philipdinn/Individual-Project/Hình/370251362_1060291348654980_7661585356005845768_n.jpg

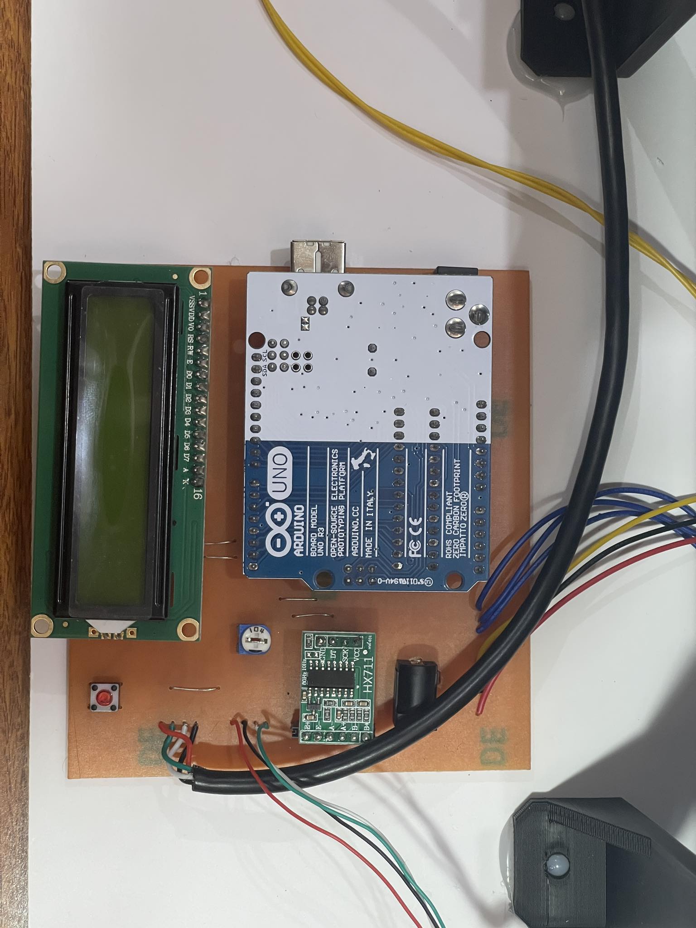
Hình/370251362_1060291348654980_7661585356005845768_n.jpg
