philipdinn/Individual-Project/Hình/12VDC cũ.jpg

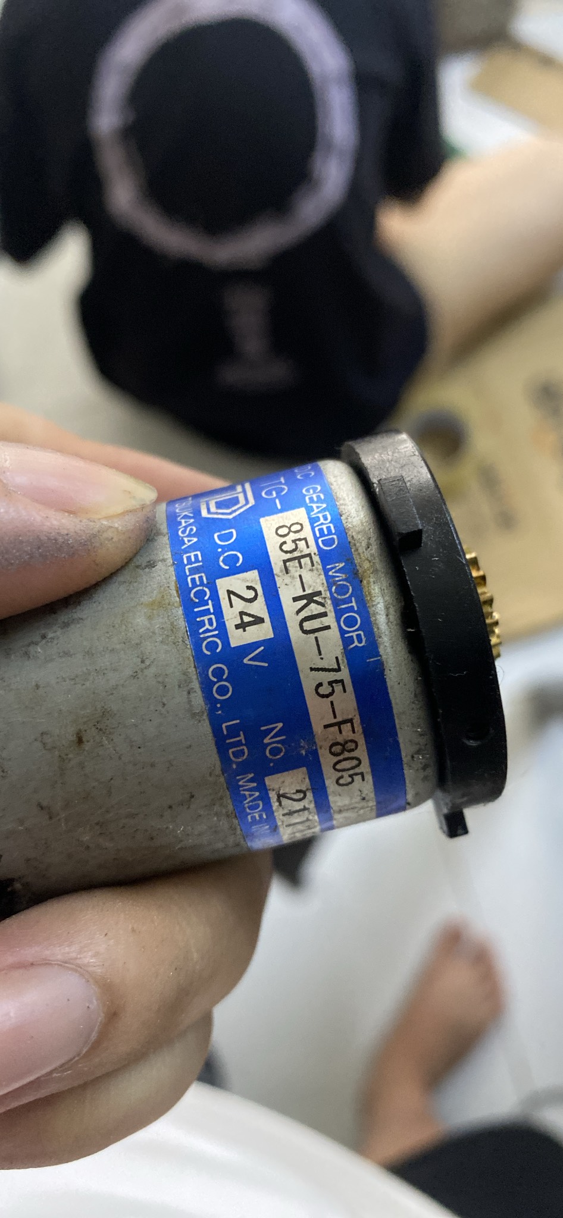
Hình/12VDC cũ.jpg
