philipdinn/Individual-Project/README.md

# Individual-Project
Precision weighing and speed monitoring on conveyor systems are essential for quality and efficiency in modern manufacturing. Traditional static scales can't measure the weight of moving products. Dynamic weighing systems solve this by accurately measuring product weight while they move down the conveyor, without halting the belt.
