philipdinn/Individual-Project/Hình Khối.pptx

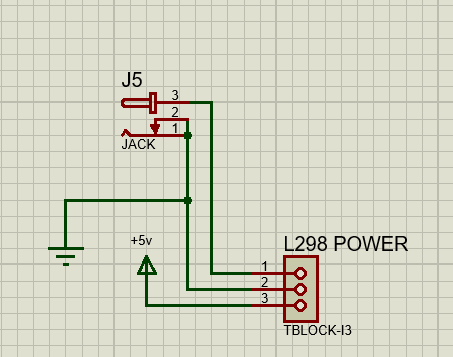
[picture p8: figure]

POWER BLOCK

## Slide 2

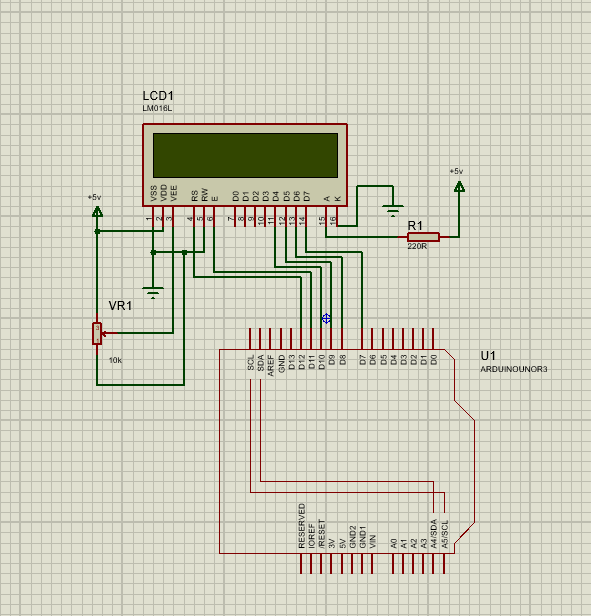
[picture p9: figure]

DISPLAY BLOCK

## Slide 3

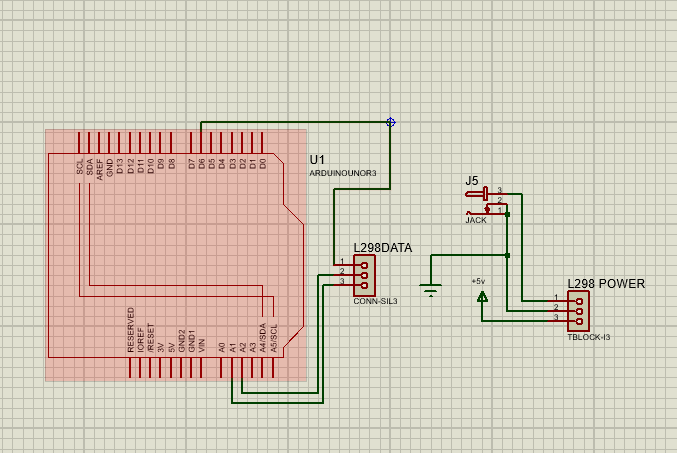
[picture p10: figure]

L298N BLOCK

## Slide 4

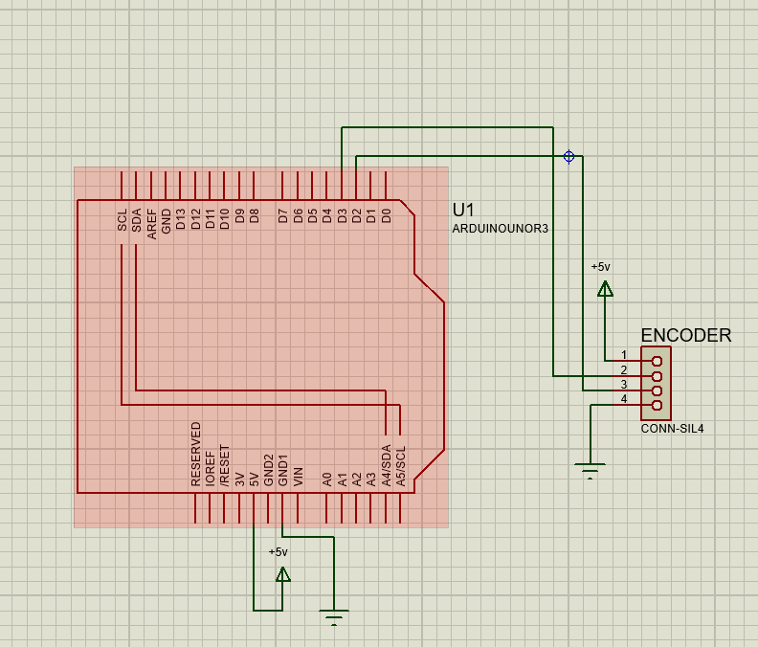
[picture p11: figure]

ENCODER BLOCK

## Slide 5

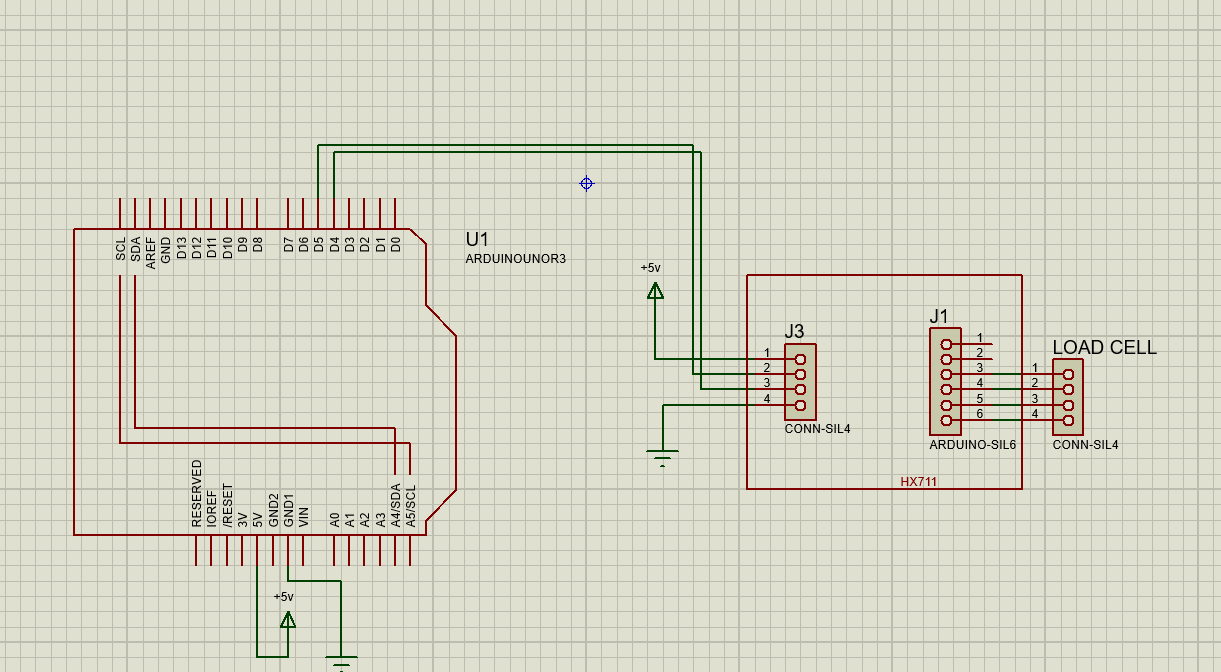
[picture p12: figure]

LOADCELL BLOCK

## Slide 6

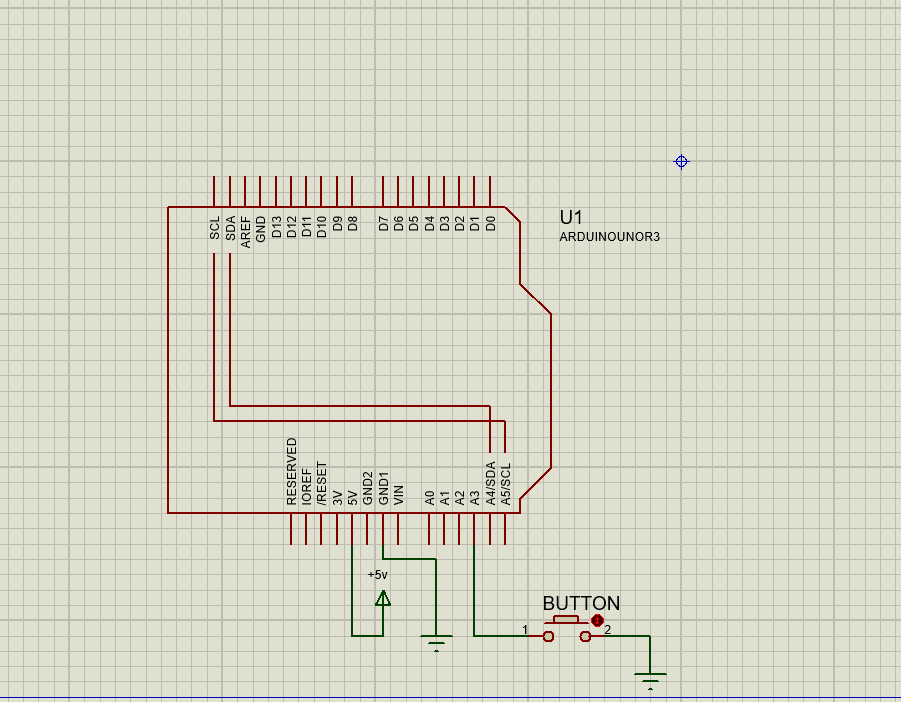
[picture p13: figure]

MAIN PROCESSING BLOCK

## Slide 7

## Slide 8

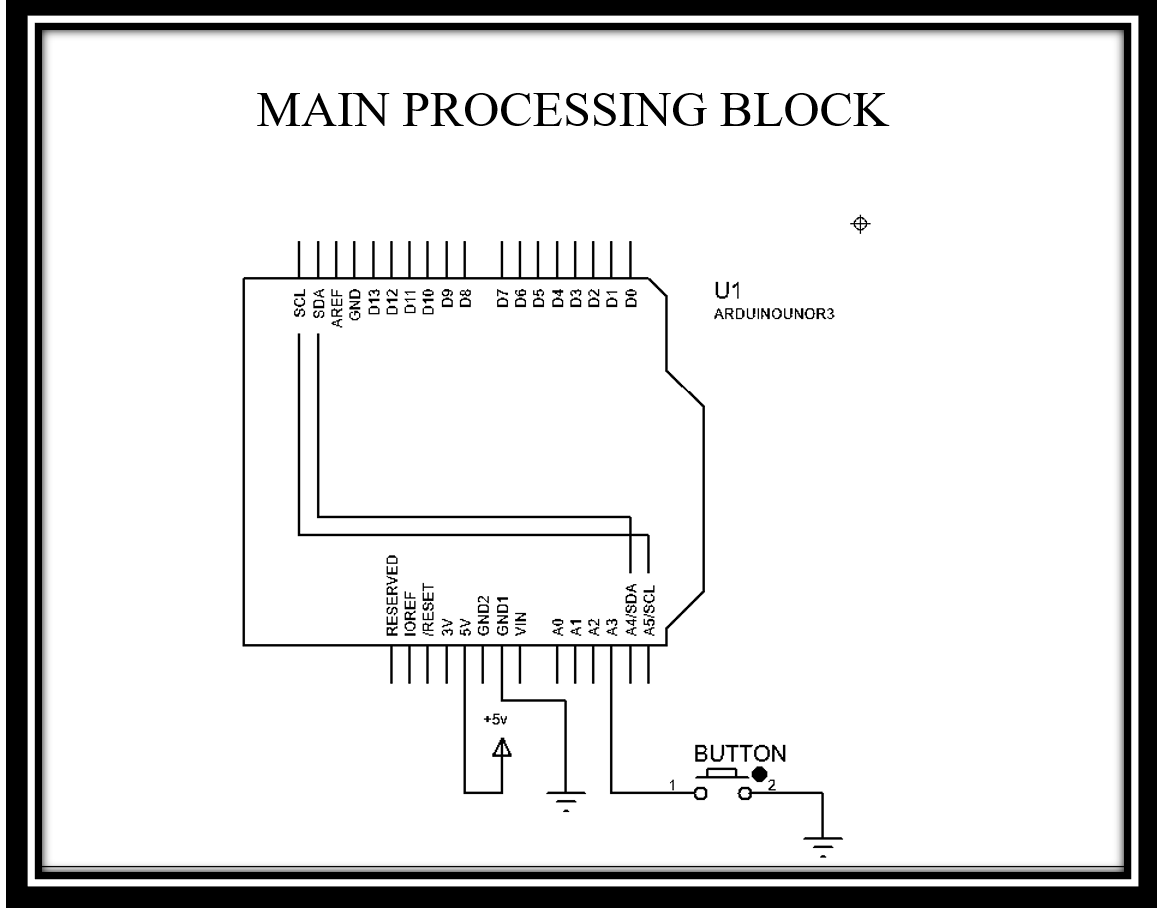
[picture p14: figure]
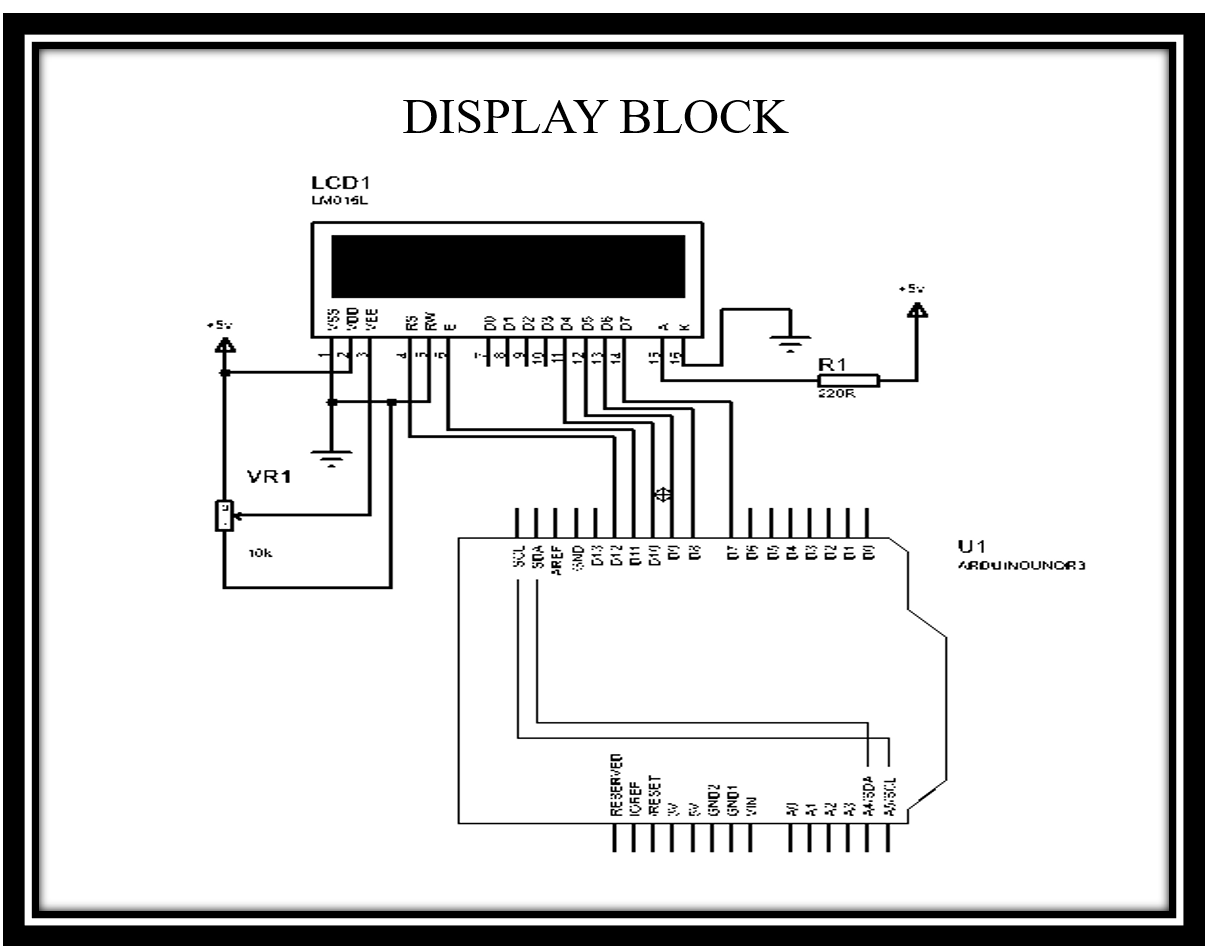
[picture p15: figure]
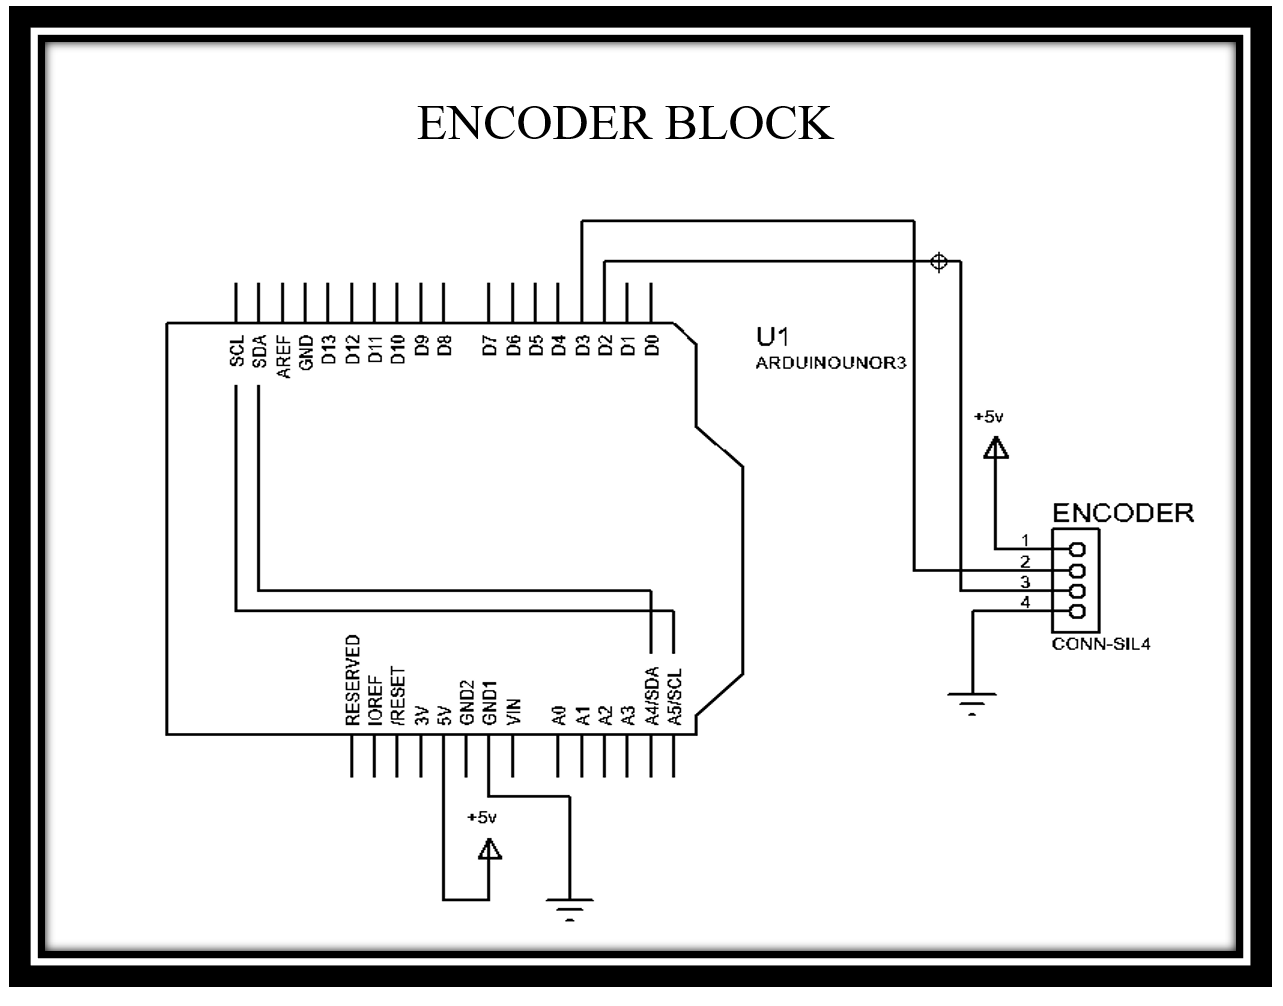
[picture p16: figure]
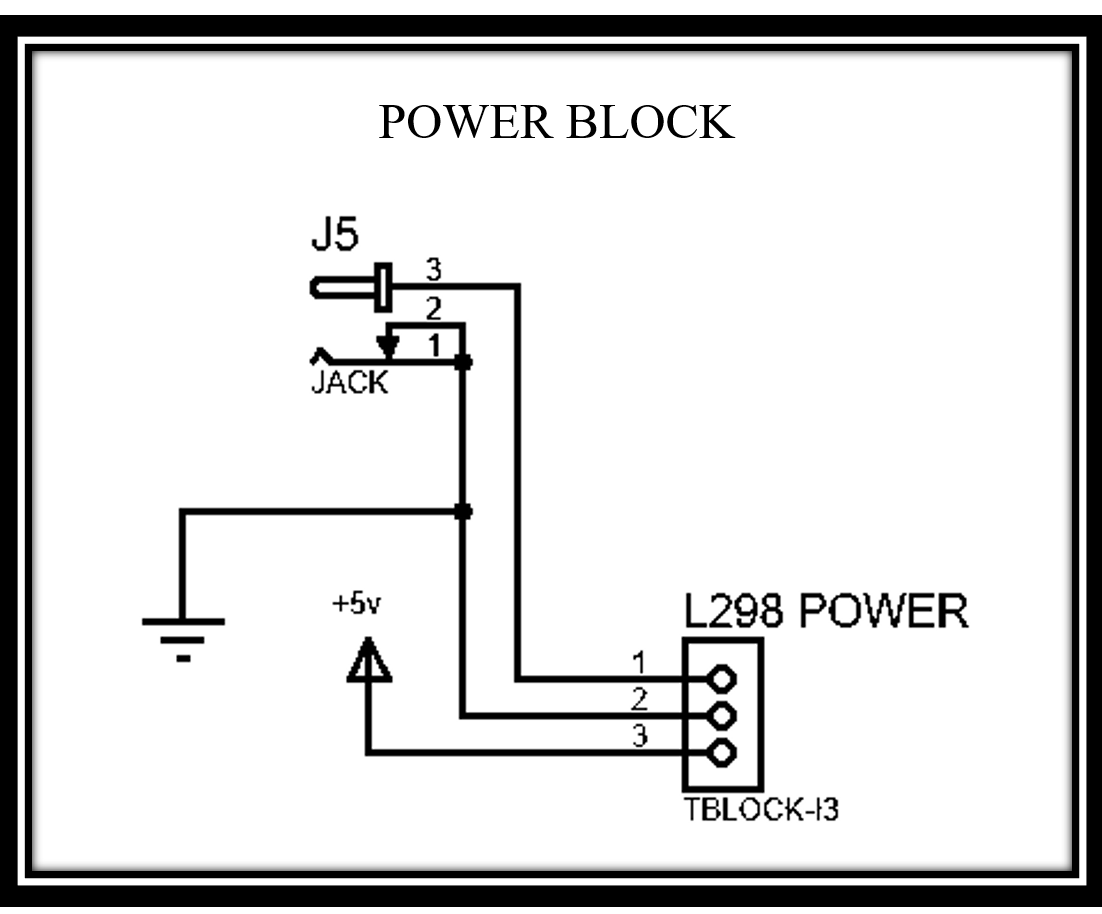
[picture p17: figure]
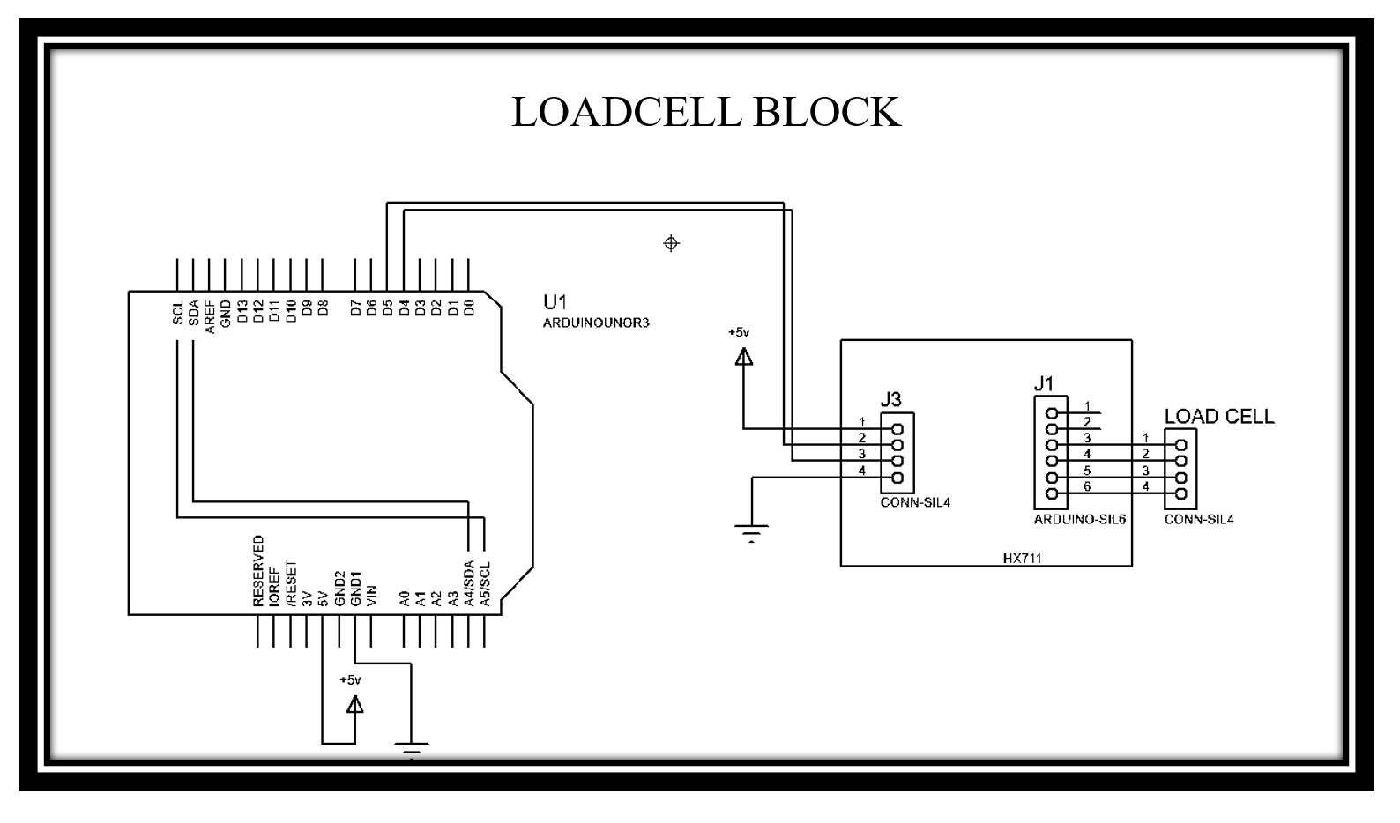
[picture p18: figure]
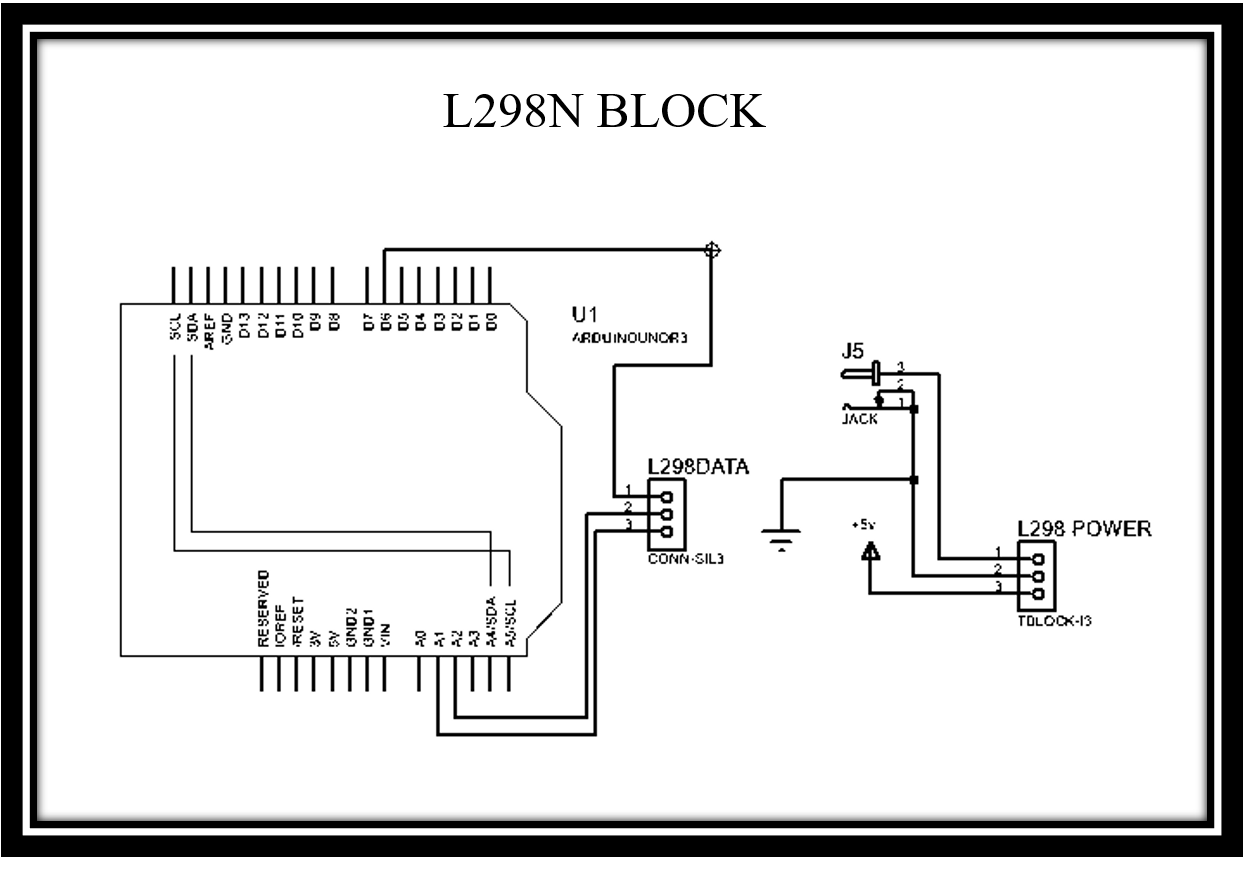
[picture p19: figure]

## Slide 9

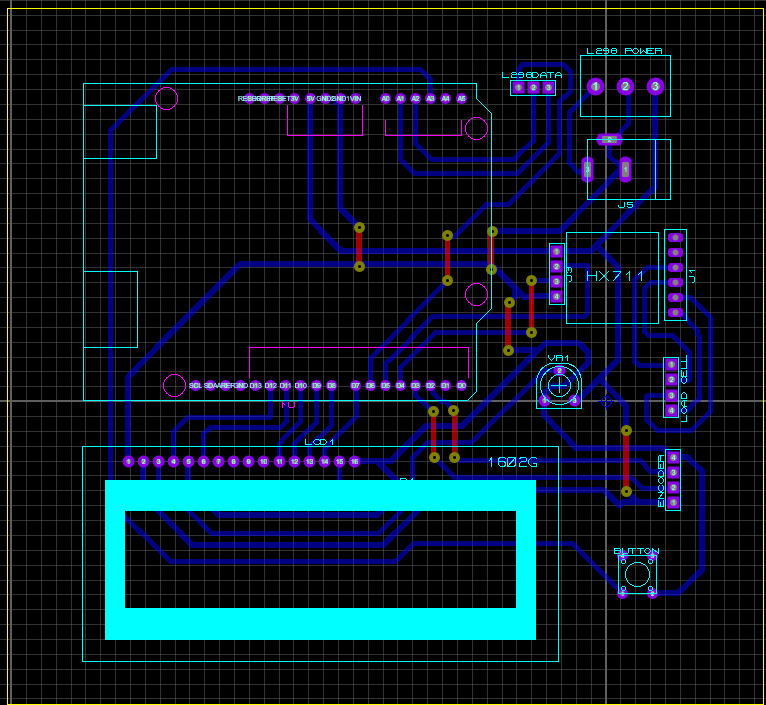
[picture p20: figure]
