philipdinn/Individual-Project/Hình/50.png

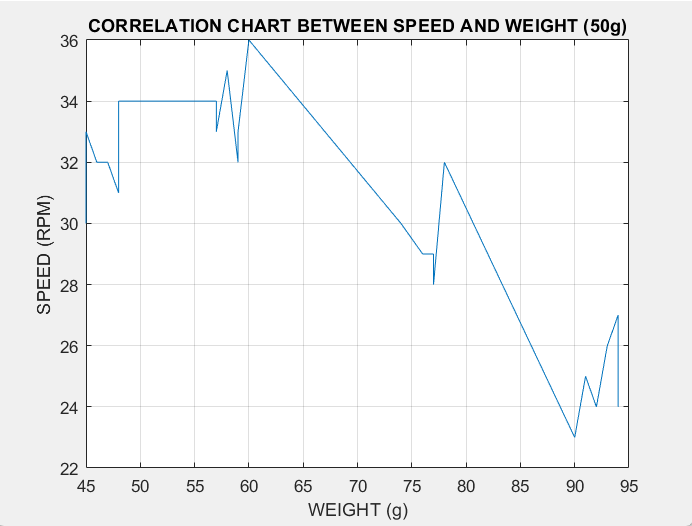
Hình/50.png
