philipdinn/Individual-Project/Hình/70.png

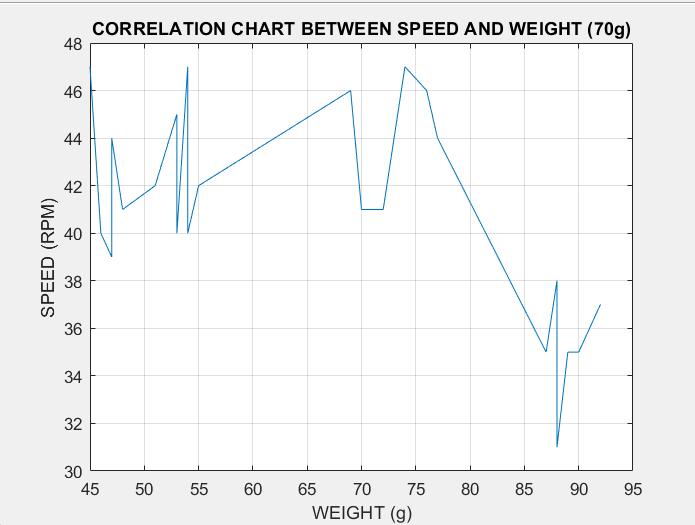
Hình/70.png
