philipdinn/Individual-Project/Hình/90.png

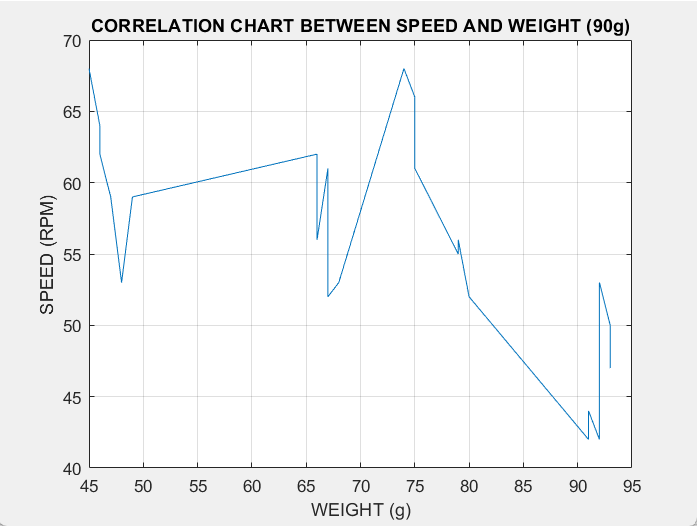
Hình/90.png
