philipdinn/Individual-Project/Hình/100.png

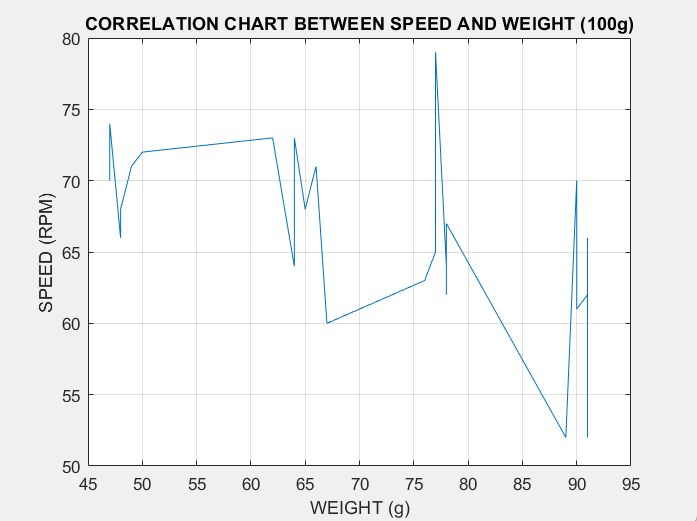
Hình/100.png
