philipdinn/Individual-Project/Hình/370220347_3696432520637470_9133561006674503579_n.jpg

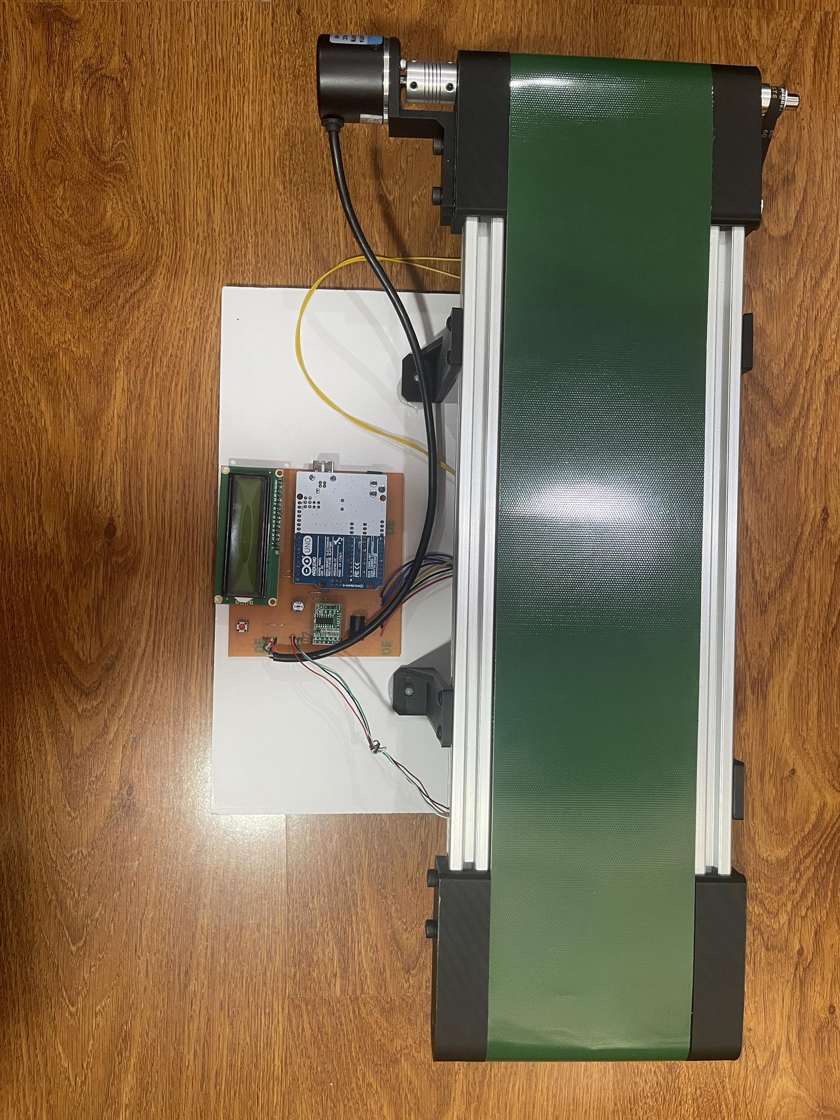
Hình/370220347_3696432520637470_9133561006674503579_n.jpg
