philipdinn/Individual-Project/Hình/Khối - TA.png

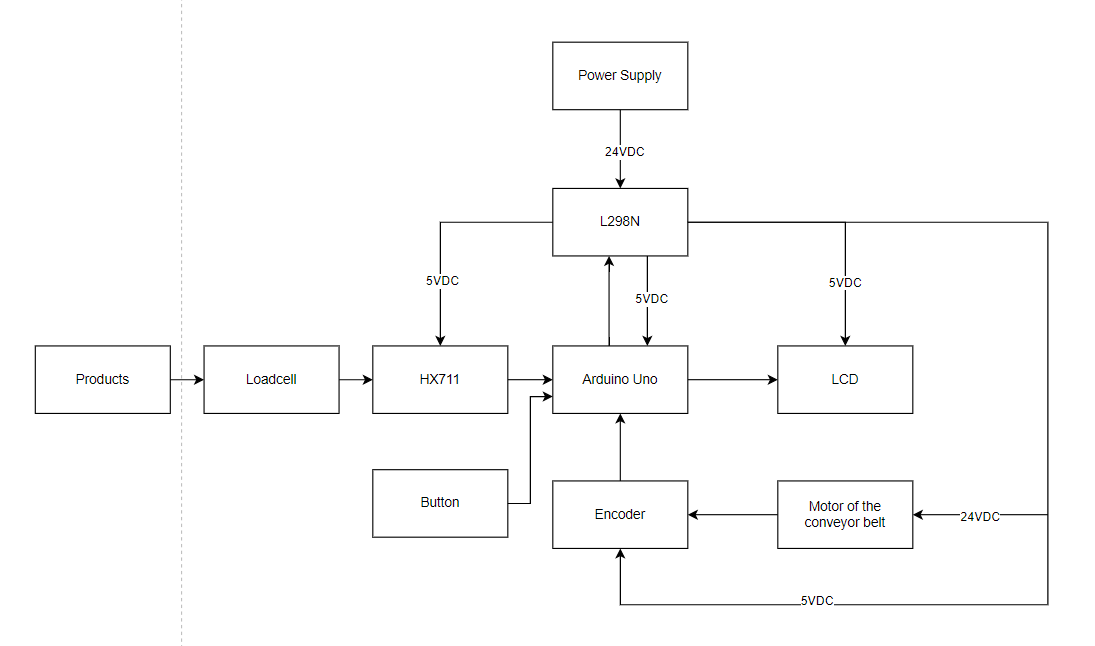
Hình/Khối - TA.png
