philipdinn/Individual-Project/Hình/L298.bmp

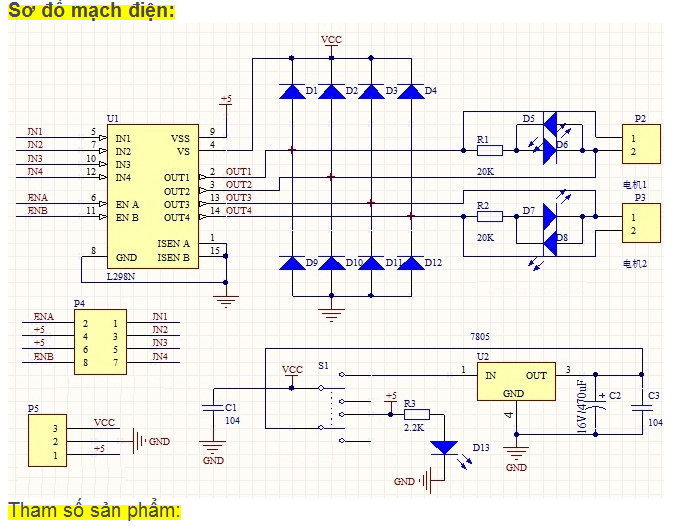
Hình/L298.bmp
