philipdinn/Individual-Project/Hình/Lưu đồ .png

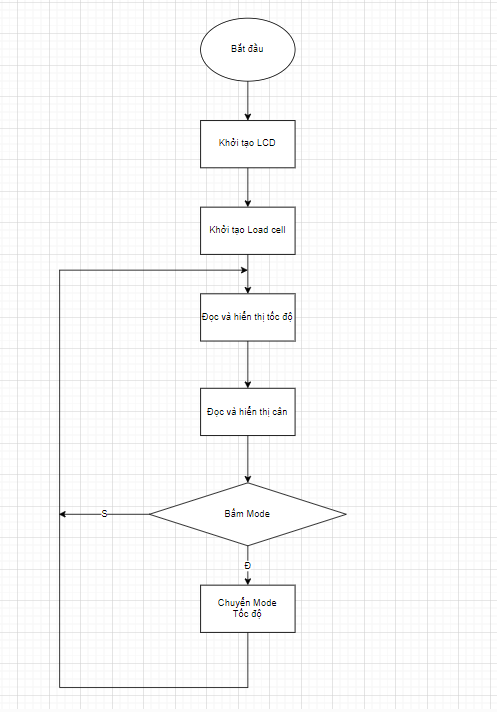
Hình/Lưu đồ .png
