philipdinn/Individual-Project/Hình/PP2/1.png

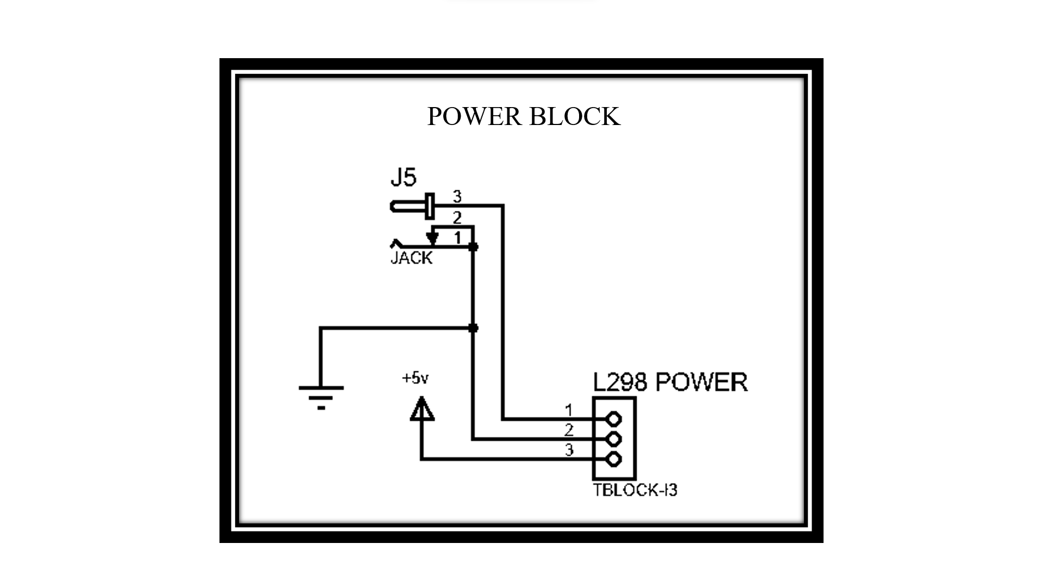
Hình/PP2/1.png
