philipdinn/Individual-Project/Hình/PP2/FULL.png

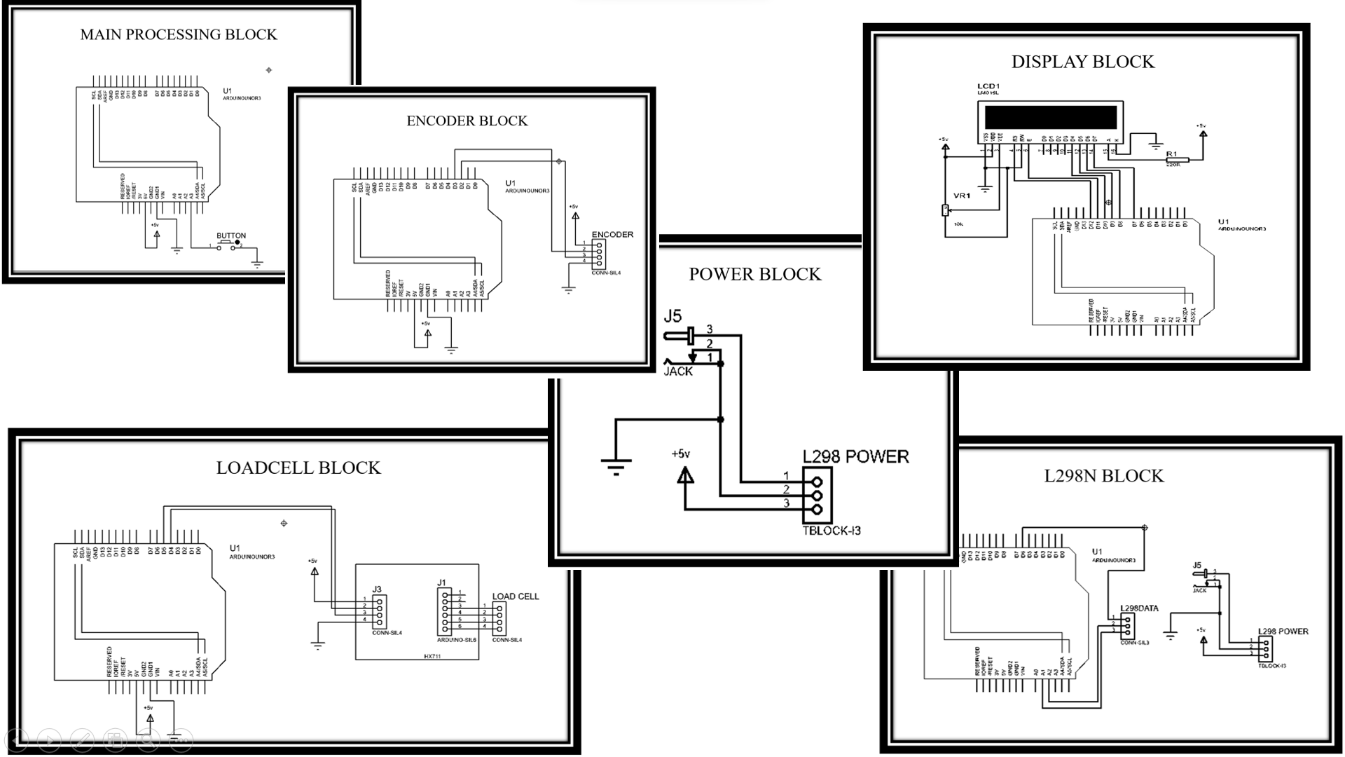
Hình/PP2/FULL.png
