philipdinn/Individual-Project/Hình/PP2/MẠCH IN 2.png

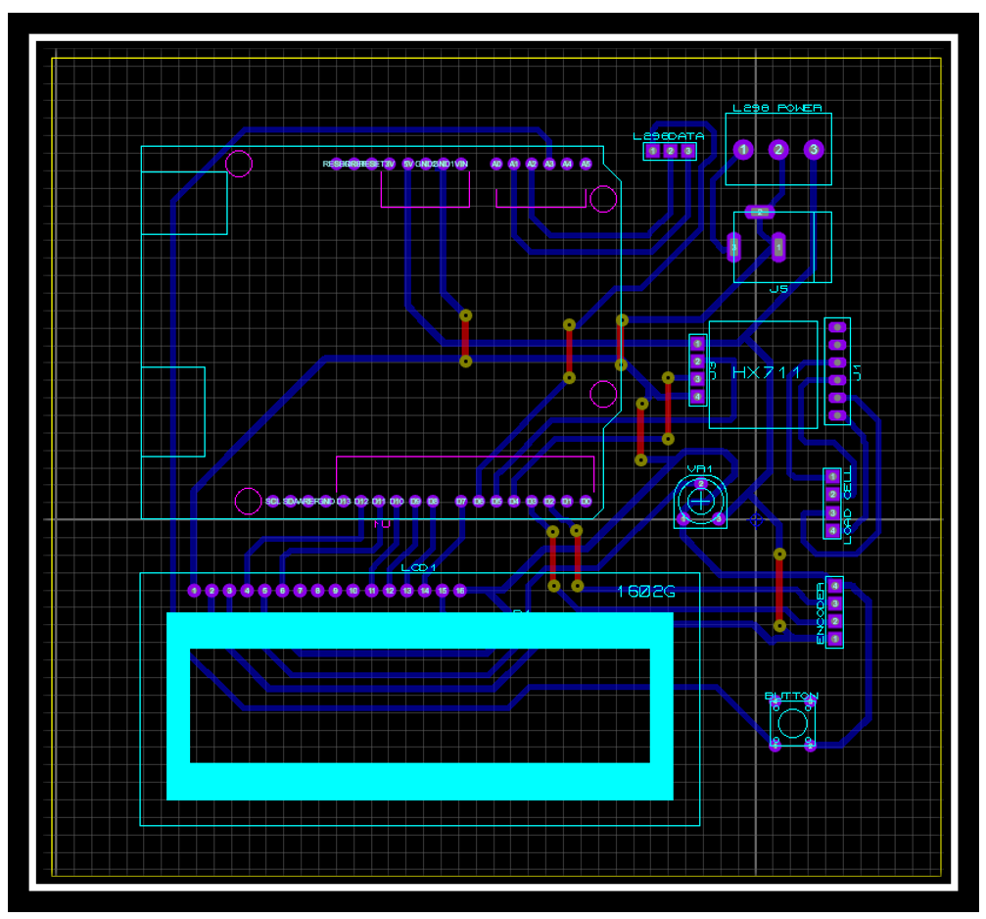
Hình/PP2/MẠCH IN 2.png
