philipdinn/Individual-Project/Hình/PP2/Screenshot 2023-11-28 121640.png

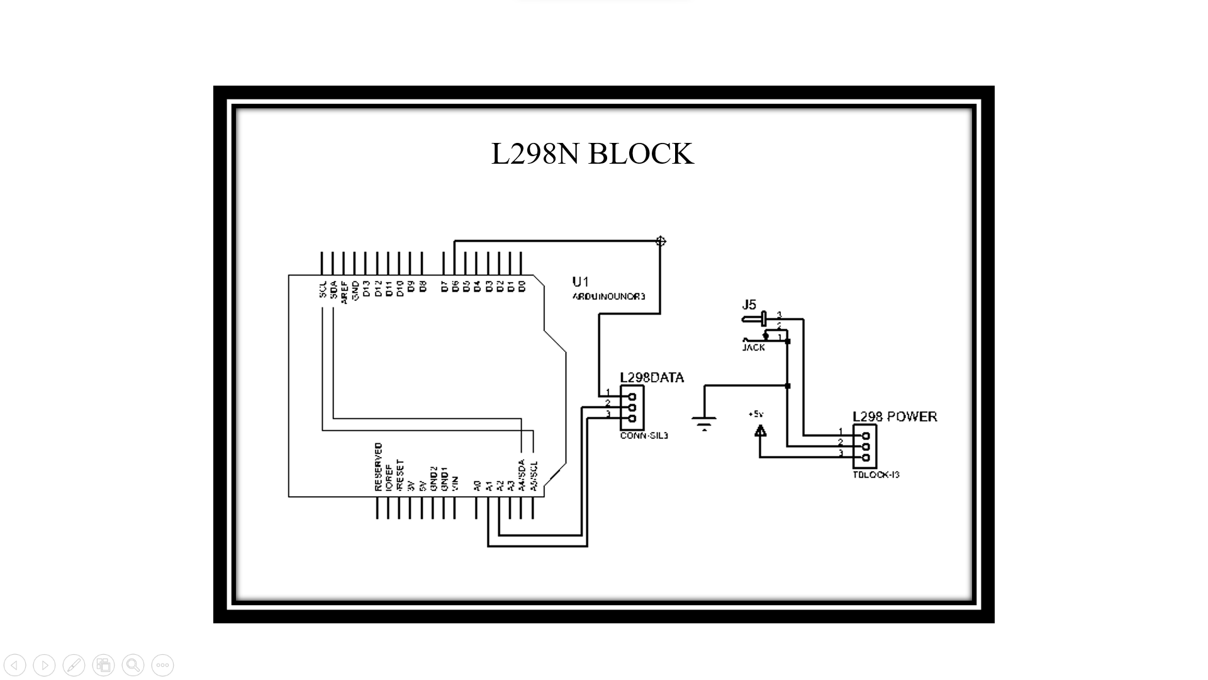
Hình/PP2/Screenshot 2023-11-28 121640.png
