philipdinn/Individual-Project/Hình/PP2/Screenshot 2023-11-28 121646.png

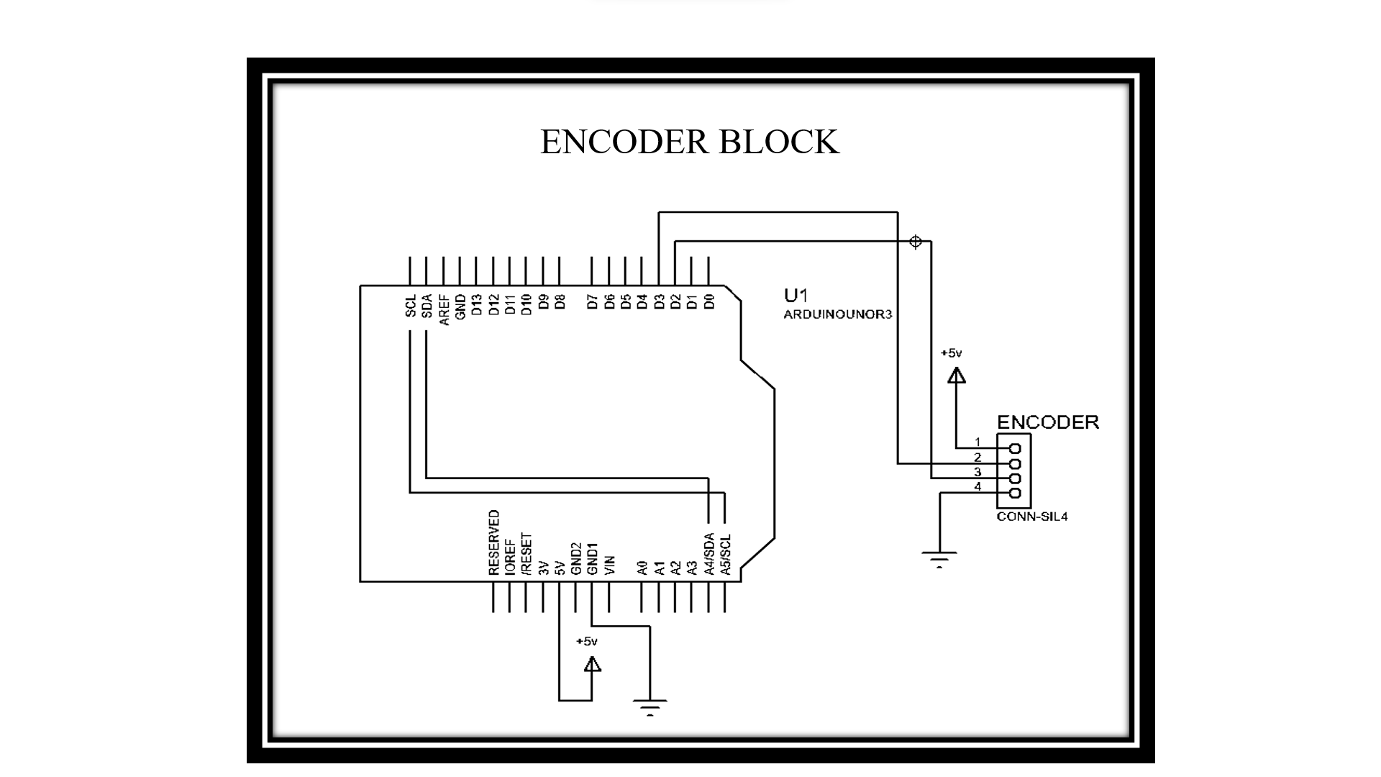
Hình/PP2/Screenshot 2023-11-28 121646.png
