philipdinn/Individual-Project/Hình/PP2/Screenshot 2023-11-28 121731.png

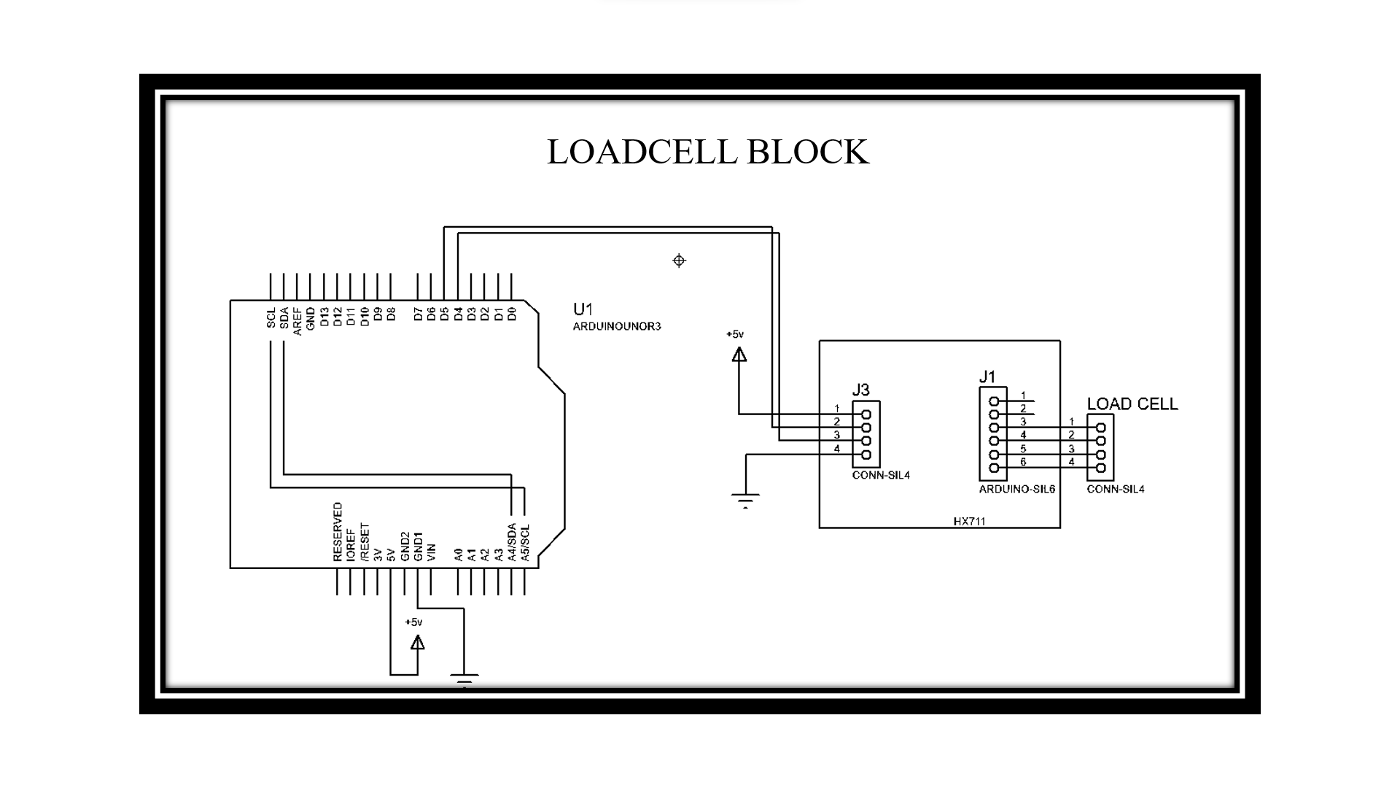
Hình/PP2/Screenshot 2023-11-28 121731.png
