philipdinn/Individual-Project/Hình/sơ đồ nguyên lý (proteus).png

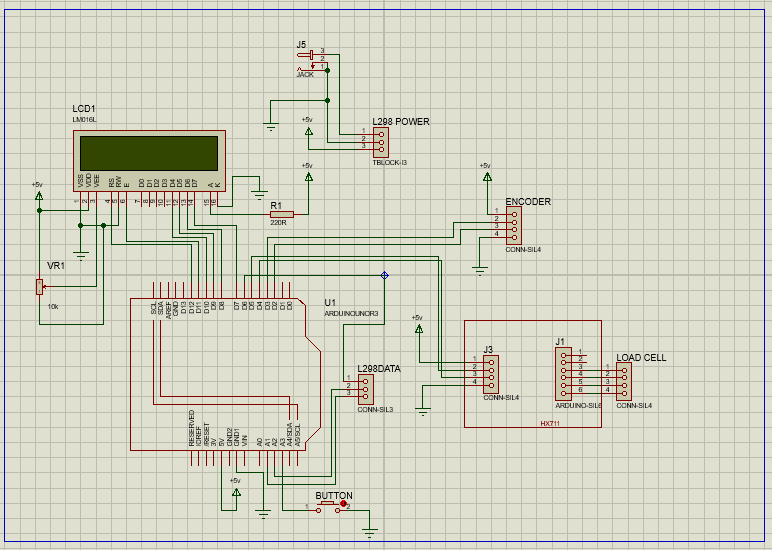
Hình/sơ đồ nguyên lý (proteus).png
