philipdinn/Individual-Project/Hình/ĐC băng chuyền.jpg

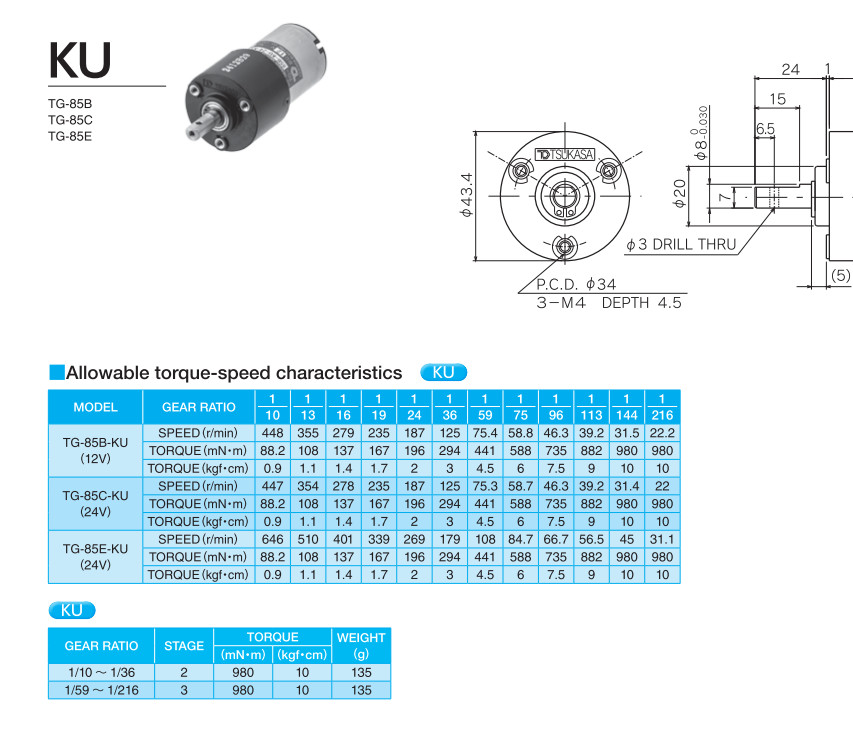
Hình/ĐC băng chuyền.jpg
